STARS-Design-Track-2024/nebula-ii/(commit log)

2025-06-14 Integrated SRAM with user_project_wrapper. SKIPPED DRC!
    [macro.cfg, metrics.csv, user_project_wrapper.sdf]
2025-06-15 Integrated 32x1024 SRAM with user_project_wrapper. SKIPPED DRC!
    [macro.cfg, metrics.csv, user_project_wrapper.sdf]
